WellsWang/MSXLinkCart/CartridgeShell/CartCoverArt/cart_label_front.png

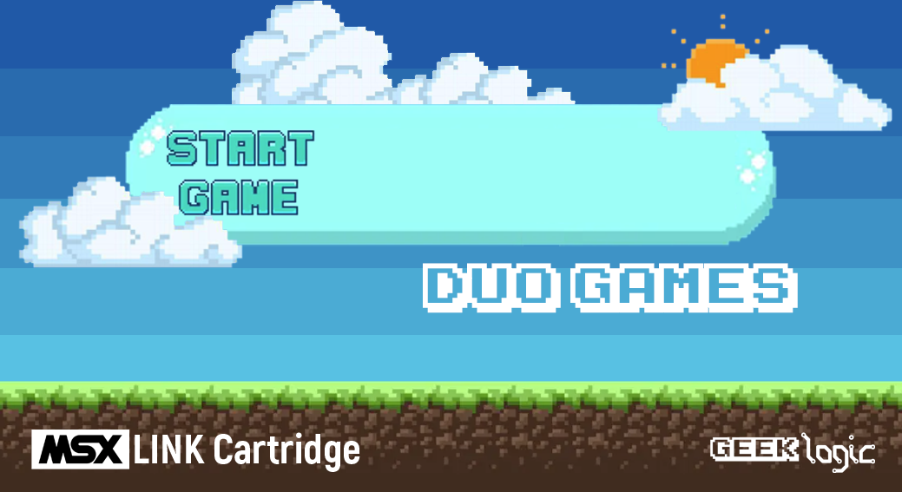
CartridgeShell/CartCoverArt/cart_label_front.png
