WellsWang/MSXLinkCart/PCB/BOM_MSXLinkCart.V1.csv

No. | Quantity | Comment | Designator | Footprint | Value | Manufacturer Part | Manufacturer | Supplier Part | Supplier
1 | 1 | 4.7uF | C1 | C0805 | 4.7uF | CGA0805X7R475K350MT | HRE(芯声) | C6119943 | LCSC
2 | 1 | 2.2uF | C2 | C0805 | 2.2uF | CL21A225KBQNNNE | SAMSUNG(三星) | C377773 | LCSC
3 | 7 | 100nF | C3,C4,C5,C6,C7,C10,C11 | C0805 | 100nF | FCC0805B104K500DT | FOJAN(富捷) | C5137467 | LCSC
4 | 2 | 22pF | C8,C9 | C0805 | 22pF | CL21C220JBANNNC | SAMSUNG(三星) | C1804 | LCSC
5 | 1 | 100uF | C12 | CAP-SMD_BD6.3-L6.6-W6.6-LS7.6-FD-1 | 100uF | RVE100UF35V67RV0072 | KNSCHA(科尼盛) | C2836437 | LCSC
6 | 1 | MSX Cartridge Edge Connector | CONN1 | MSX 50PIN EDGE CONNECTOR
7 | 1 | PZ254V-11-04P | Display | HDR-TH_4P-P2.54-V-M |  | PZ254V-11-04P | XFCN(兴飞) | C2691448 | LCSC
8 | 1 | ICSP | H1 | HDR-TH_6P-P2.54-V-M-R2-C3-S2.54 |  | ICSP | XFCN(兴飞) | C492420 | LCSC
9 | 1 | POWER | LED1 | LED0805-FD |  | POWER | EVERLIGHT(亿光) | C2971978 | LCSC
10 | 1 | RX | LED2 | LED0805-FD |  | RX | EVERLIGHT(亿光) | C2971978 | LCSC
11 | 1 | TX | LED3 | LED0805-FD |  | TX | EVERLIGHT(亿光) | C2971978 | LCSC
12 | 2 | BC847 | Q1,Q3 | SOT-23-3_L2.9-W1.3-P1.90-LS2.4-BR |  | BC847 | SHIKUES(时科) | C475630 | LCSC
13 | 2 | BC857 | Q2,Q4 | SOT-23-3_L2.9-W1.3-P1.90-LS2.4-BR |  | BC857 | ZRE(治润) | C779725 | LCSC
14 | 2 | 470Ω | R1,R2 | R0805 | 470Ω | 0805W8F4700T5E | UNI-ROYAL(厚声) | C17710 | LCSC
15 | 1 | 10kΩ | R3 | R0805 | 10kΩ | ERJ-U06F1002V | PANASONIC(松下) | C1013448 | LCSC
16 | 5 | 1kΩ | R4,R5,R6,R7,R8 | R0805 | 1kΩ | ERJ-U06F1001V | PANASONIC(松下) | C4026491 | LCSC
17 | 6 | 12kΩ | R9,R10,R11,R13,R14,R15 | R0805 | 12kΩ | ESR10EZPJ123 | ROHM(罗姆) | C2077536 | LCSC
18 | 2 | 10kΩ | R12,R16 | R0805 | 10kΩ | 0805W8F1002T5E | UNI-ROYAL(厚声) | C17414 | LCSC
19 | 4 | 1kΩ | RN1,RN2,RN3,RN4 | RES-ARRAY-SMD_0603-8P-L3.2-W1.6-BL | 1kΩ | 4D03WGJ0102T5E | UNI-ROYAL(厚声) | C20197 | LCSC
20 | 1 | RESET | SW1 | SW-SMD_L3.9-W3.0-P4.45 |  | RESET | XUNPU(讯普) | C720477 | LCSC
21 | 1 | MSS-23D18G4 051 | SW2 | SW-TH_HX-MSS-23D18GX051 |  | MSS-23D18G4 051 | SHOU HAN(首韩) | C7507436 | LCSC
22 | 1 | TC-6610-9-260G | SW3 | SW-TH_4P-L5.0-W5.0-P4.50-LS6.5 |  | TC-6610-9-260G | HCTL(华灿天禄) | C2845257 | LCSC
23 | 1 | B0512S-1WR3 | U1 | PWRM-TH_4P-L11.5-W6.1-P2.54_TME1212S |  | B0512S-1WR3 | YLPTEC(易川) | C3031179 | LCSC
24 | 1 | ATMEGA328P-AU | U2 | TQFP-32_L7.0-W7.0-P0.80-LS9.0-BL |  | ATMEGA328P-AU | MICROCHIP(美国微芯) | C14877 | LCSC
25 | 1 | CH340C | U3 | SOP-16_L10.0-W3.9-P1.27-LS6.0-BL |  | CH340C | WCH(南京沁恒) | C84681 | LCSC
26 | 1 | W27C512 | U4 | PLCC-32_L14.0-W11.4-P1.27-LS15.0-T |  | W27C512 | MICROCHIP(美国微芯) | C613963 | LCSC
27 | 2 | 74HC595 | U5,U6 | SOP-16_L9.9-W3.9-P1.27-LS6.0-BL |  | 74HC595 | GR(国睿) | C18164493 | LCSC
28 | 1 | MicroXNJ | USB1 | MICRO-USB-SMD_MICROXNJ |  | MicroXNJ | SHOU HAN(首韩) | C404969 | LCSC
29 | 1 | 16MHz | X1 | OSC-TH_L10.0-W4.5-P5.00 | 16MHz | X49SD16MSD2SC | YXC(扬兴晶振) | C16212 | LCSC
