WellsWang/MSXLinkCart/CartridgeShell/MSXLINKCart Shell Top.stl

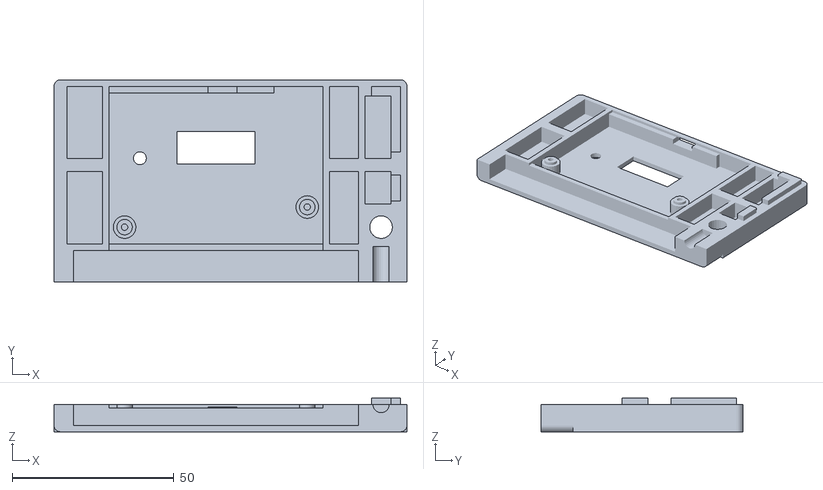
[picture p2: CAD file, 2025-09-13]
CartridgeShell/MSXLINKCart Shell Top.stl
109.0 x 62.5 x 10.4
