WellsWang/MSXLinkCart/CartridgeShell/MSXLINKCart Shell Bottom.stl

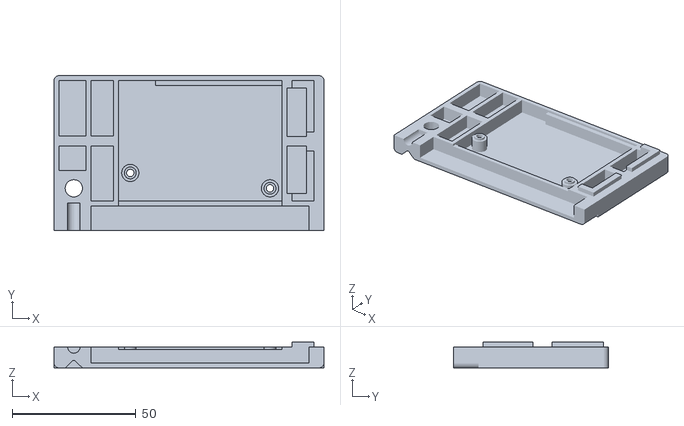
[picture p3: CAD file, 2025-08-20]
CartridgeShell/MSXLINKCart Shell Bottom.stl
109.0 x 62.5 x 10.4
