WellsWang/MSXLinkCart/(list of files, cad)

Other CAD files:
CartridgeShell/MSXLINKCart Shell Bottom.skp
CartridgeShell/MSXLINKCart Shell Top.skp
