WellsWang/MSXLinkCart/PCB/Schematics.pdf

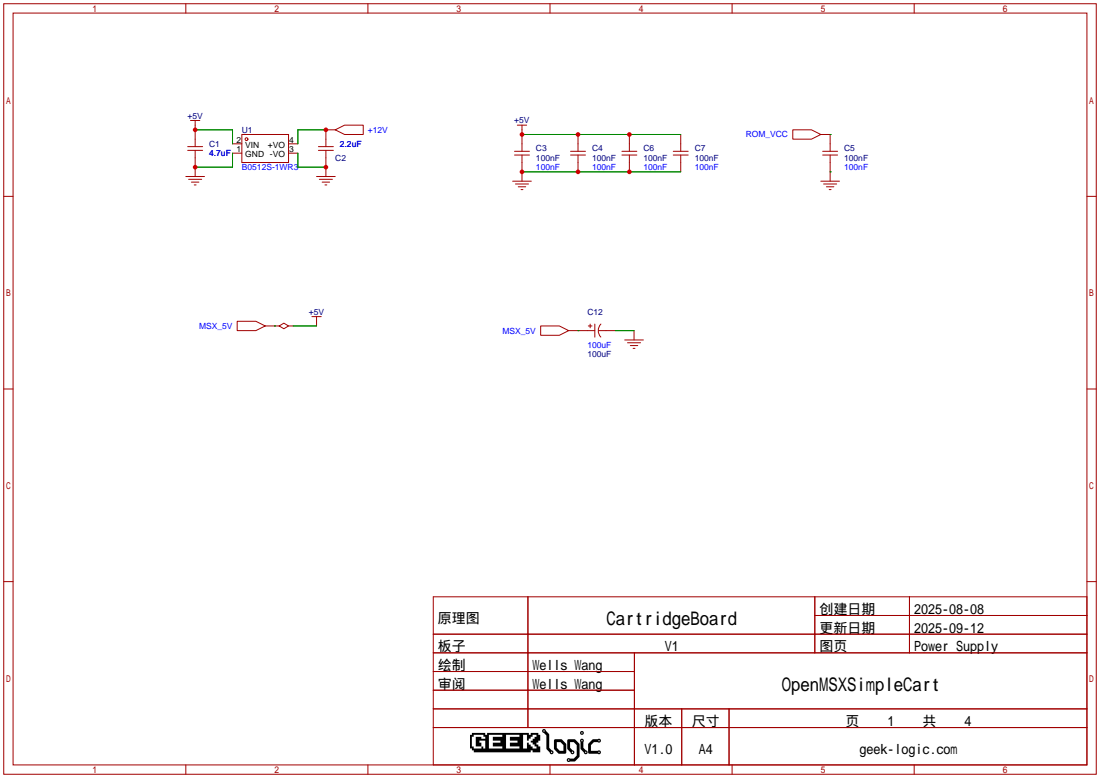
[picture p4: page 1]

原理图 | CartridgeBoard | 创建日期 | 2025-08-08

更新日期 | 2025-09-12

板子 | V1 | 图页 | Power Supply
绘制 | Wells Wang | OpenMSXSimpleCart
审阅 | Wells Wang

V1.0 | A4 | geek-logic.com

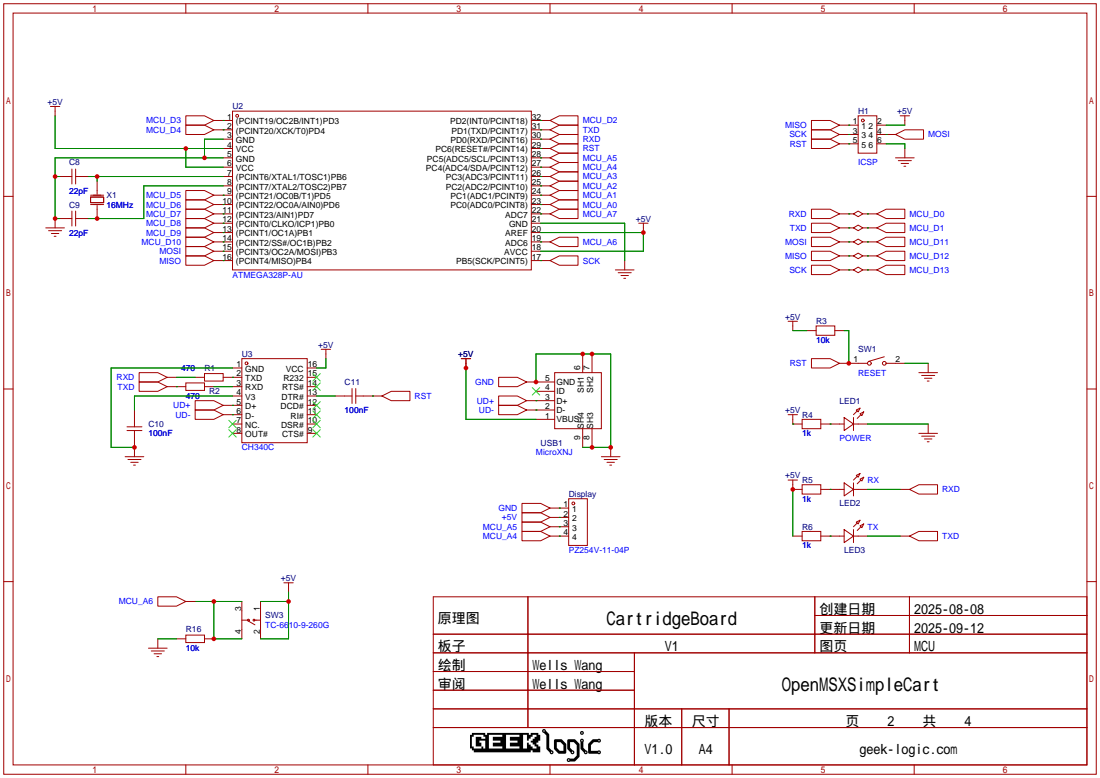
[picture p5: page 2]

DSR# 10 RI# 11 DCD# 12 DTR# 13 RTS# 14 R232 15 VCC 16

原理图 | CartridgeBoard | 创建日期 | 2025-08-08

更新日期 | 2025-09-12

板子 | V1 | 图页 | MCU
绘制 | Wells Wang | OpenMSXSimpleCart
审阅 | Wells Wang

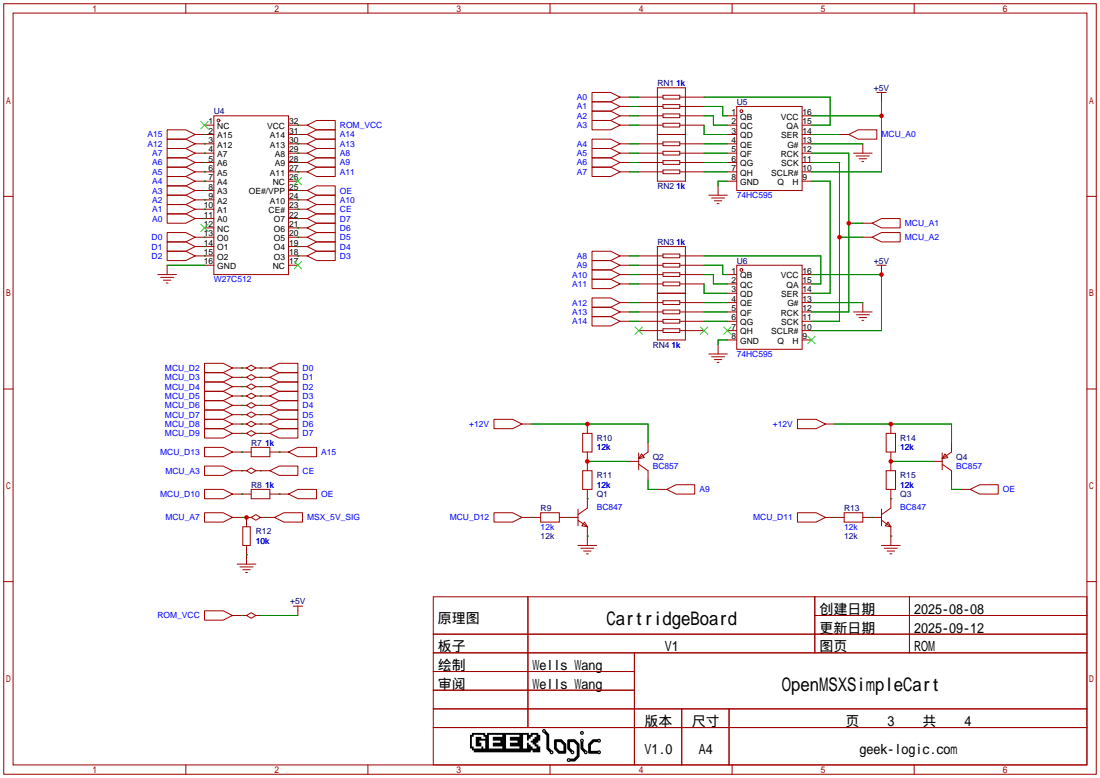
[picture p6: page 3]

SCLR# 10 SCK 11 RCK 12 G# 13 SER 14 QA 15 VCC 16

原理图 | CartridgeBoard | 创建日期 | 2025-08-08

更新日期 | 2025-09-12

板子 | V1 | 图页 | ROM
绘制 | Wells Wang | OpenMSXSimpleCart
审阅 | Wells Wang

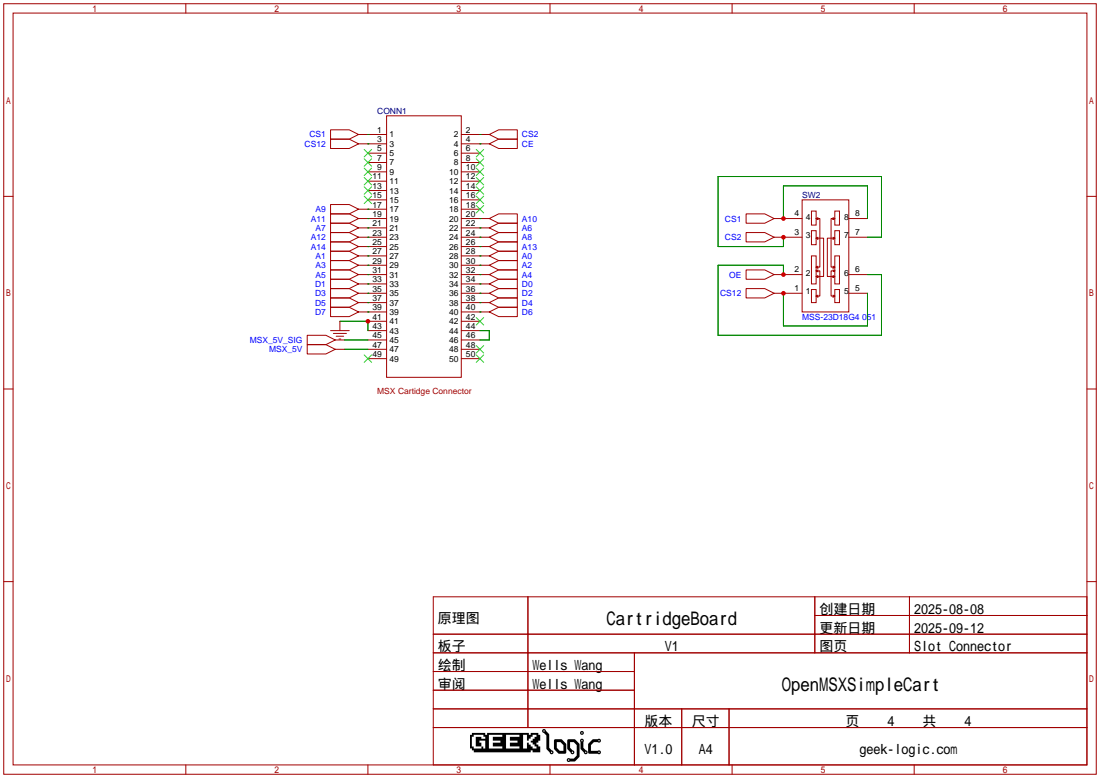
[picture p7: page 4]

原理图 | CartridgeBoard | 创建日期 | 2025-08-08

更新日期 | 2025-09-12

板子 | V1 | 图页 | Slot Connector
绘制 | Wells Wang | OpenMSXSimpleCart
审阅 | Wells Wang
