WellsWang/MSXLinkCart/(list of files, drawings)

Other design files:
PCB/MSXLinkCart.V1.epro
