WellsWang/MSXLinkCart/(commit log)

2025-08-04 Add prototype version of firmware
2025-08-06 - 修复无法擦除W27C512 Bug - 修复A15硬件设计问题导致的地址总线错误 - 增加自动判断游戏模式/烧录模式 - 增加游戏模式中游戏切换功能 - 增加OLED显示屏功能
    [MSXLINKCart.ino]
2025-08-20 Add Application Sourcecode; Add Shell 3D models.
    [MSXLINKCart Shell Bottom.skp, MSXLINKCart Shell Bottom.stl, MSXLINKCart Shell Top.skp, MSXLINKCart Shell Top.stl]
2025-09-11 Update Firmware & ProgrmaTool Application; Add CartCoverArt; Add PCB schematics and Gerbers; Add BOM files.
2025-09-13 Fix wrong Hole position
